tmurarka/Automated-Greenbox/Controls.png

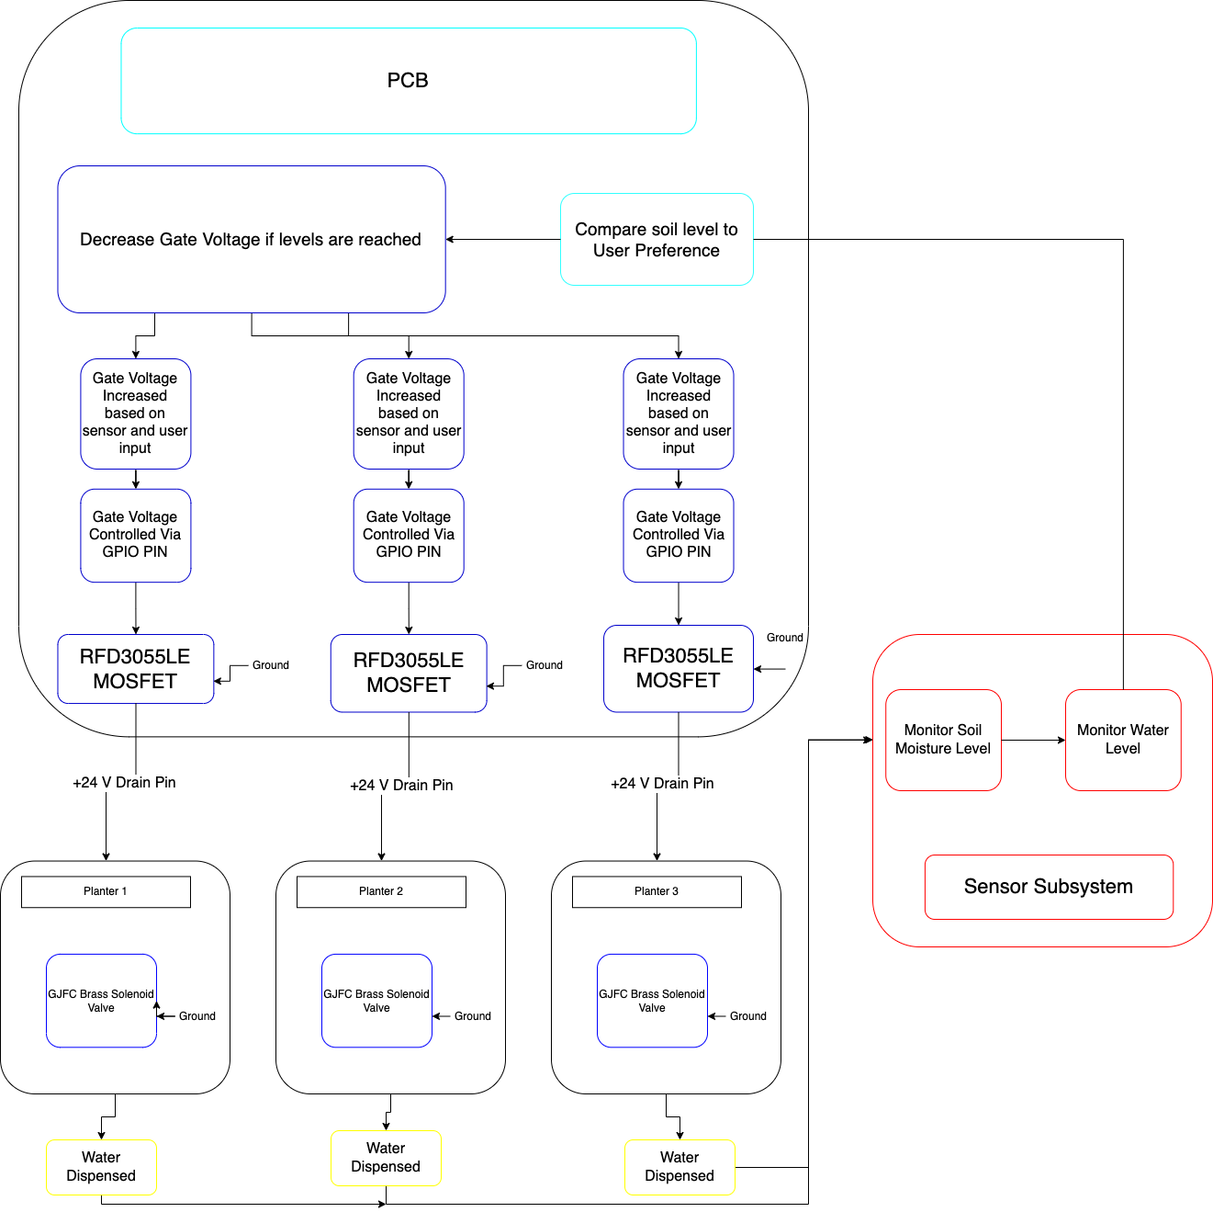
Controls.png
