tmurarka/Automated-Greenbox/PCB - Controls/Documentation/Screen Shot 2022-02-23.png

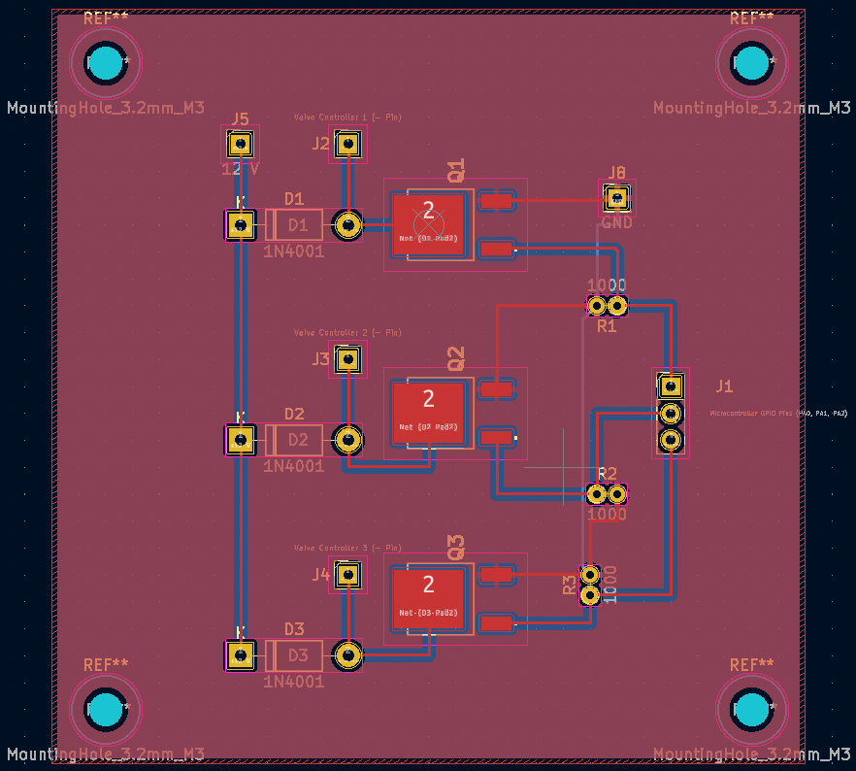
PCB - Controls/Documentation/Screen Shot 2022-02-23.png
