tmurarka/Automated-Greenbox/Picture1.png

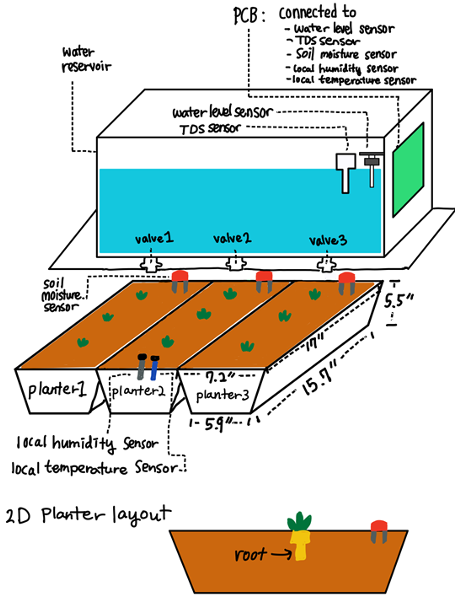
Picture1.png
