tmurarka/Automated-Greenbox/PCB - Controls/Documentation/Schematic.pdf

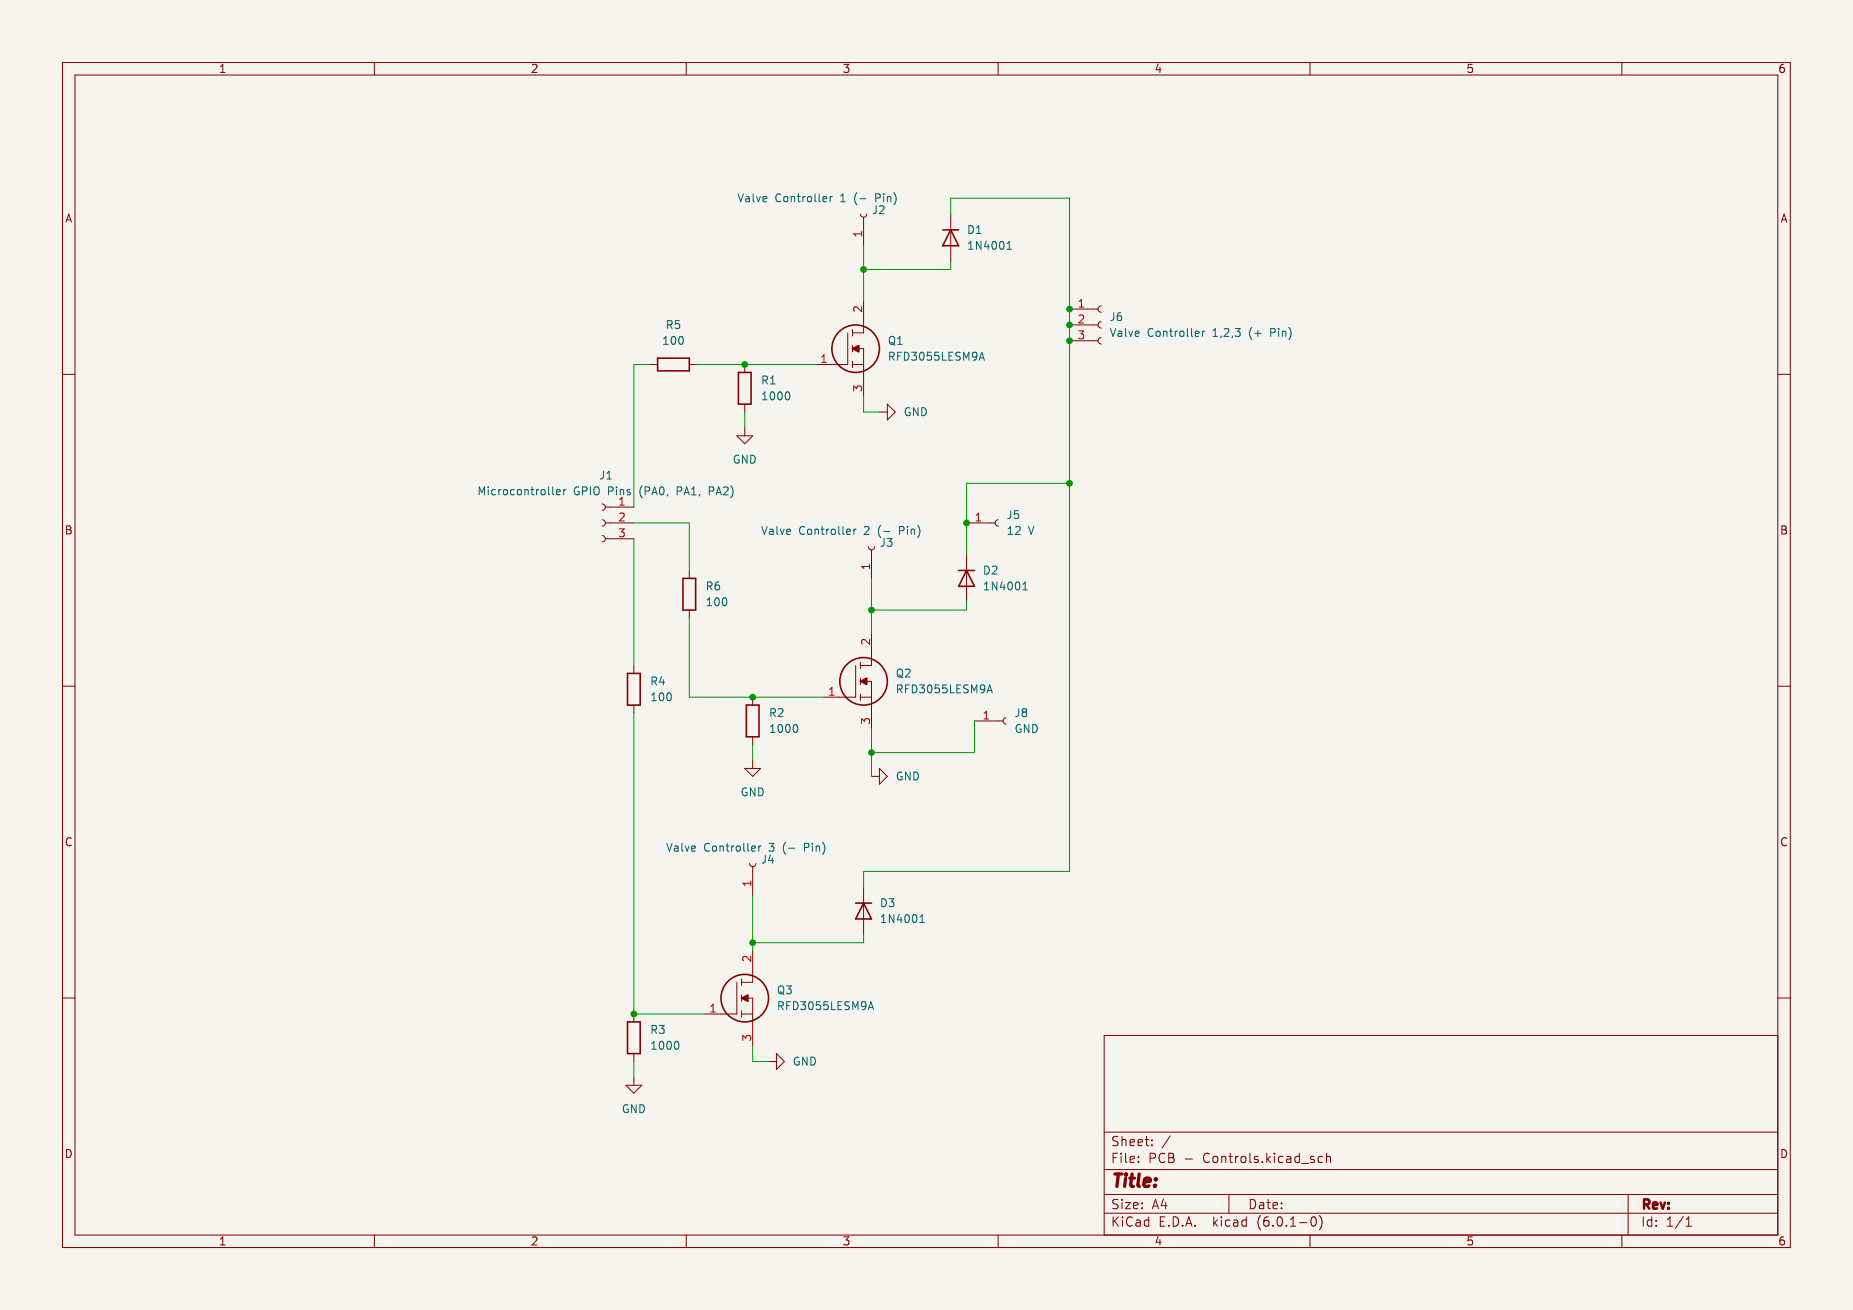
[picture p6: page 1]
