tmurarka/Automated-Greenbox/PCB - Controls/Documentation/Board.pdf

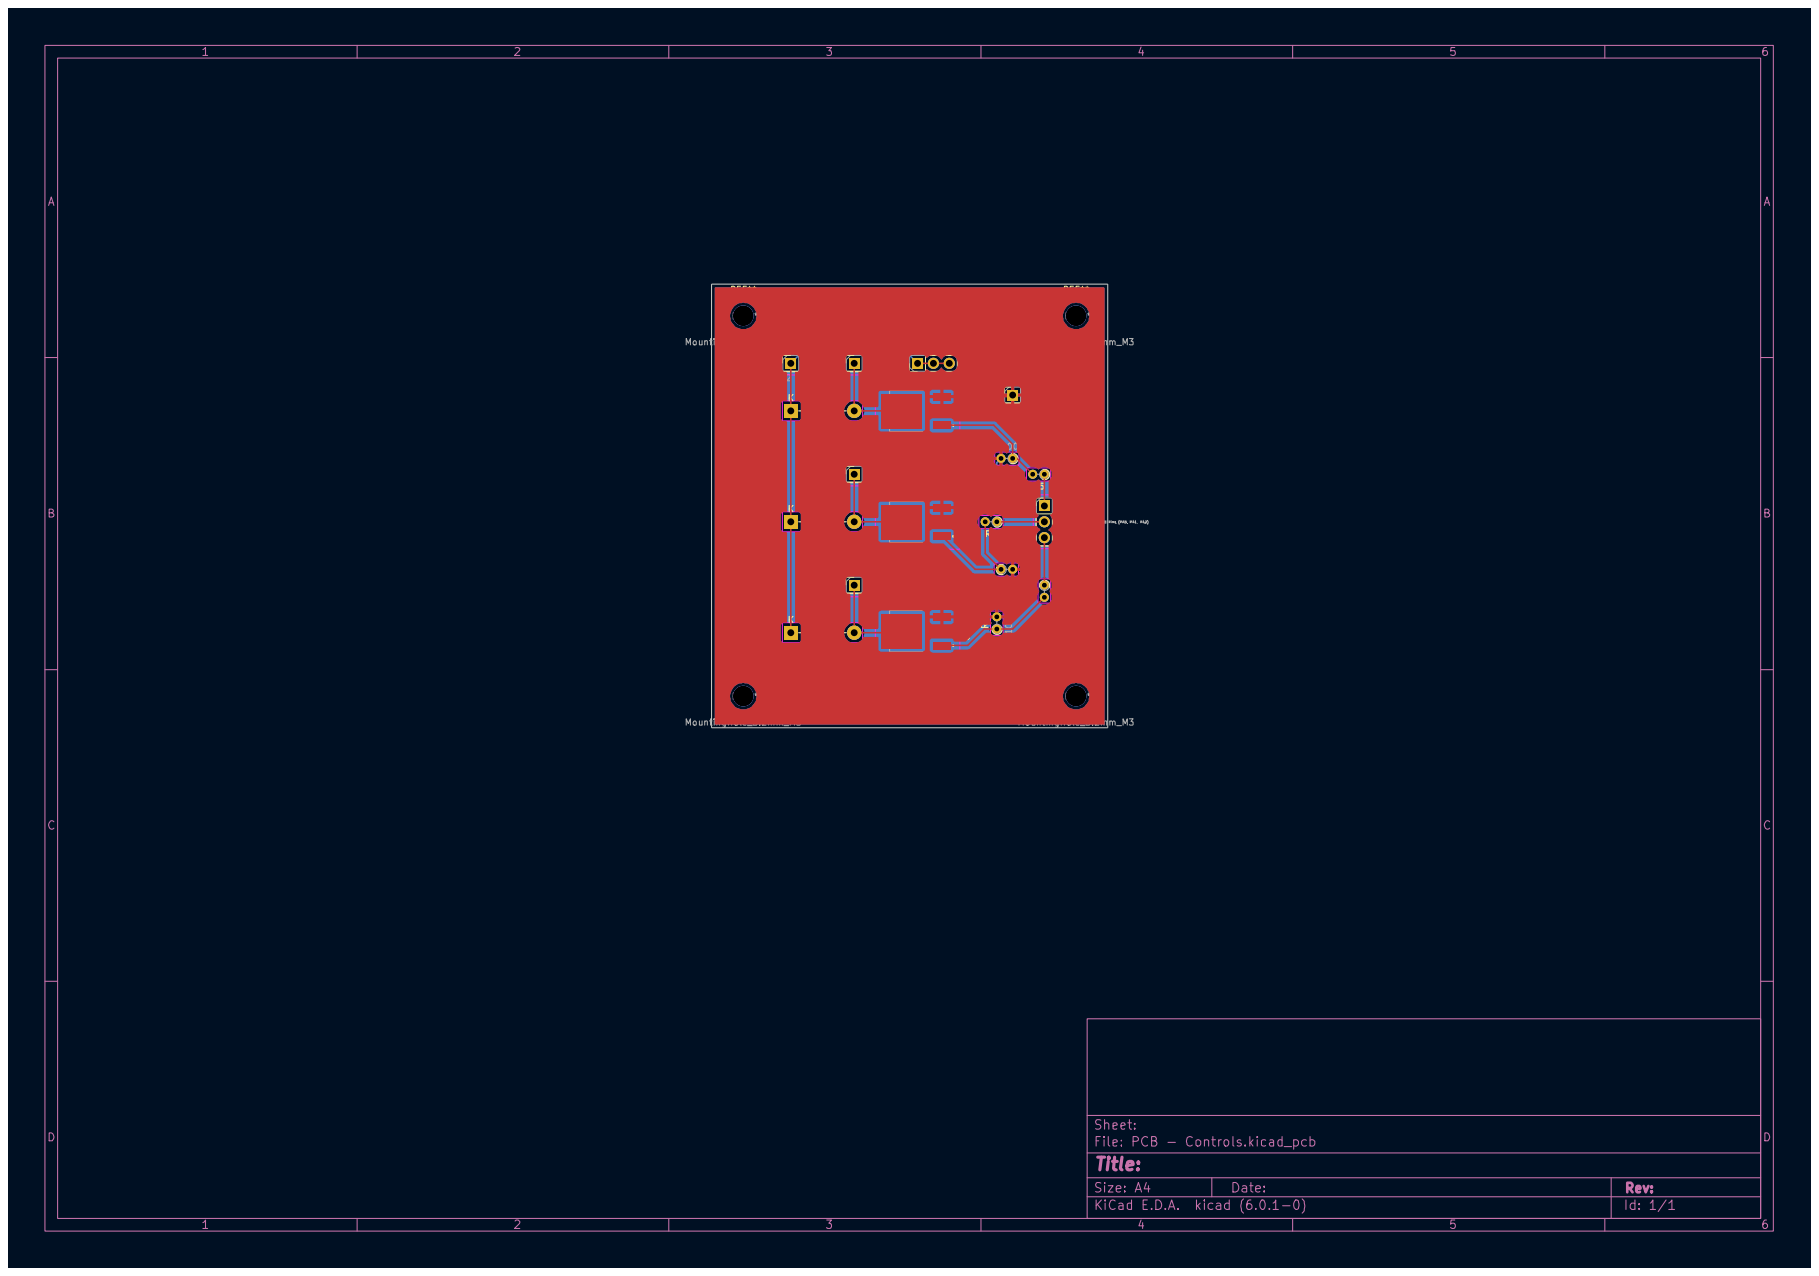
[picture p7: page 1]
