tmurarka/Automated-Greenbox/PCB - Controls/Documentation/PCB_Review.pdf

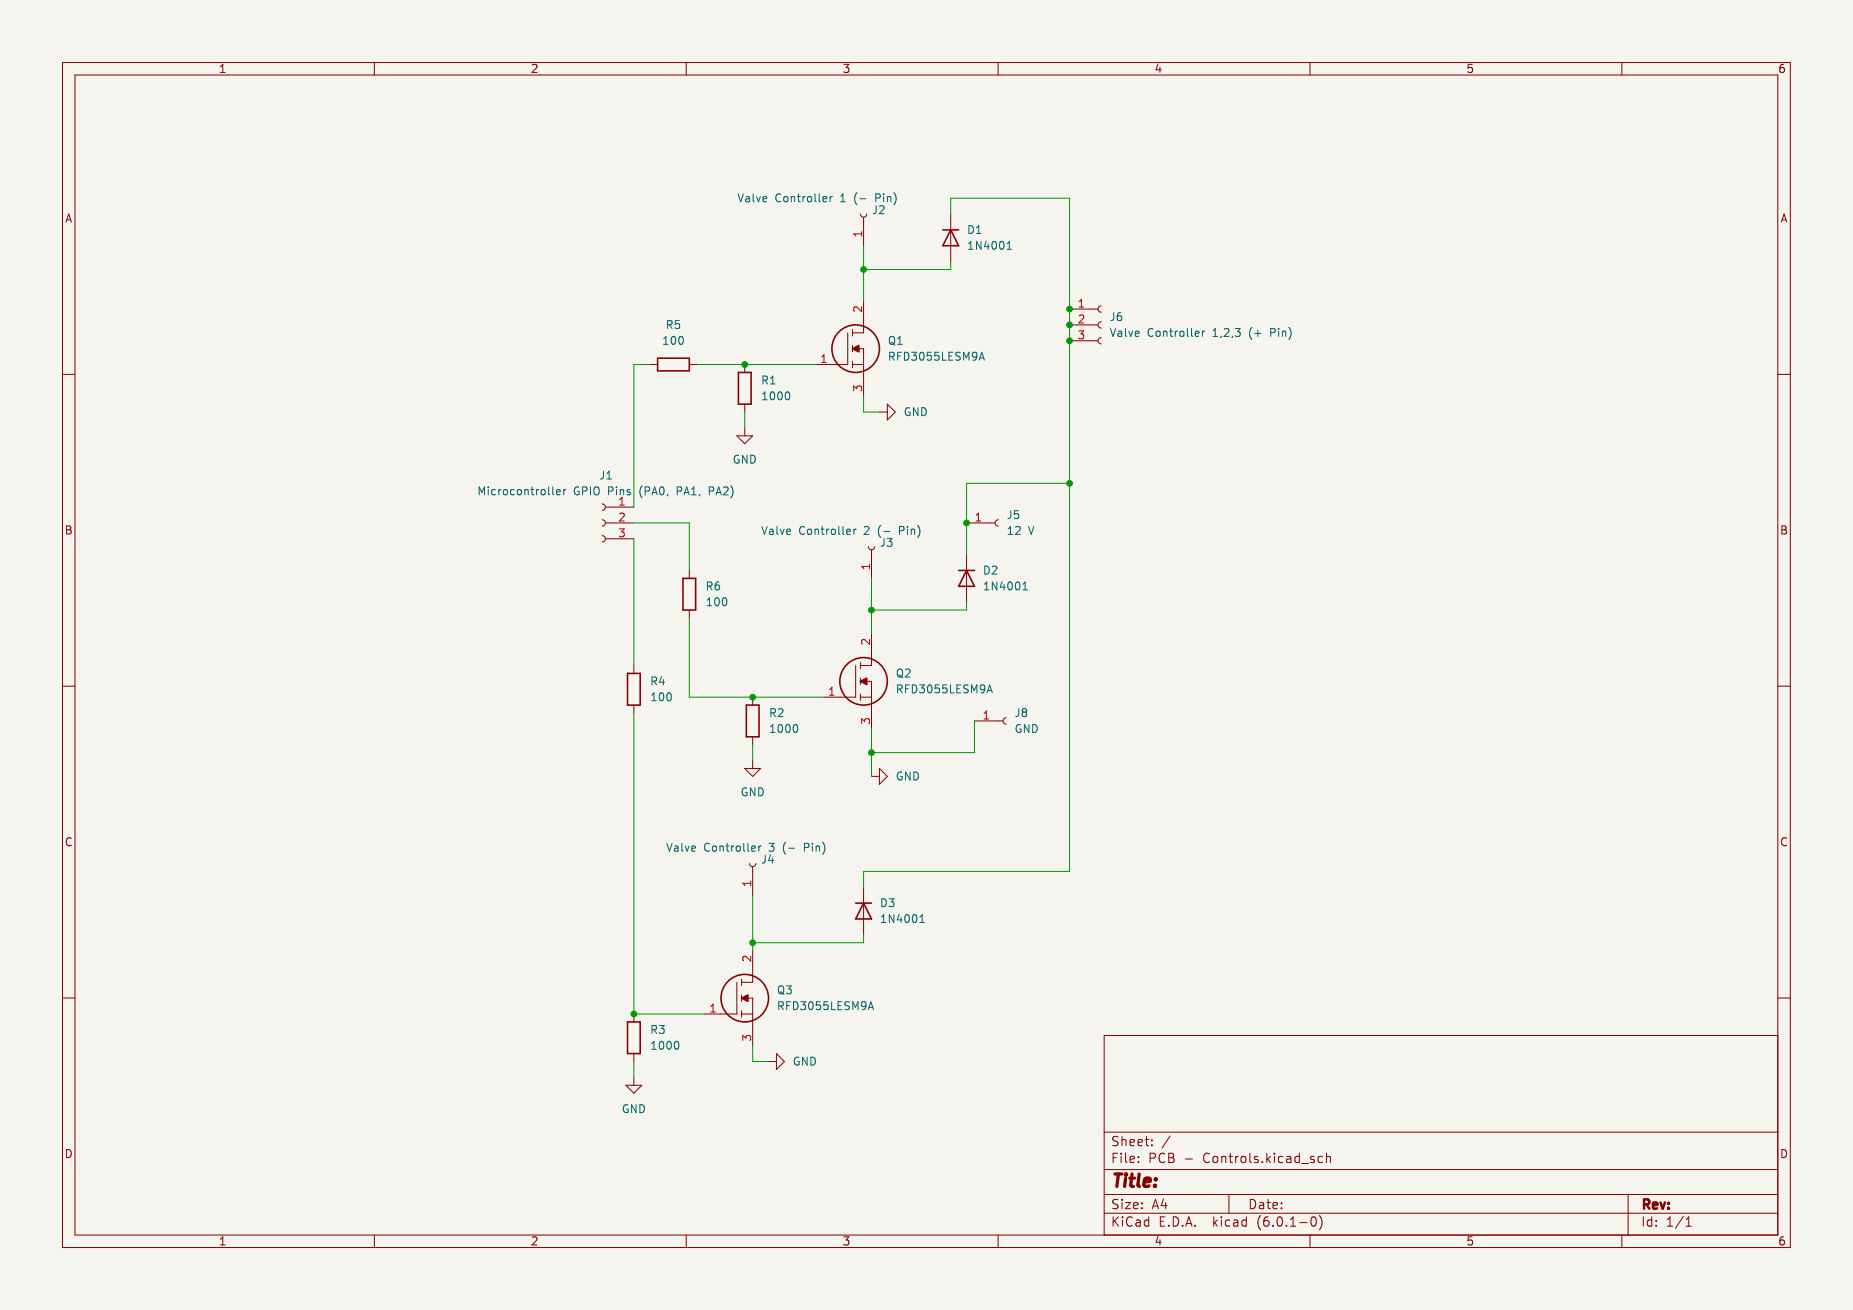
[picture p8: page 1]

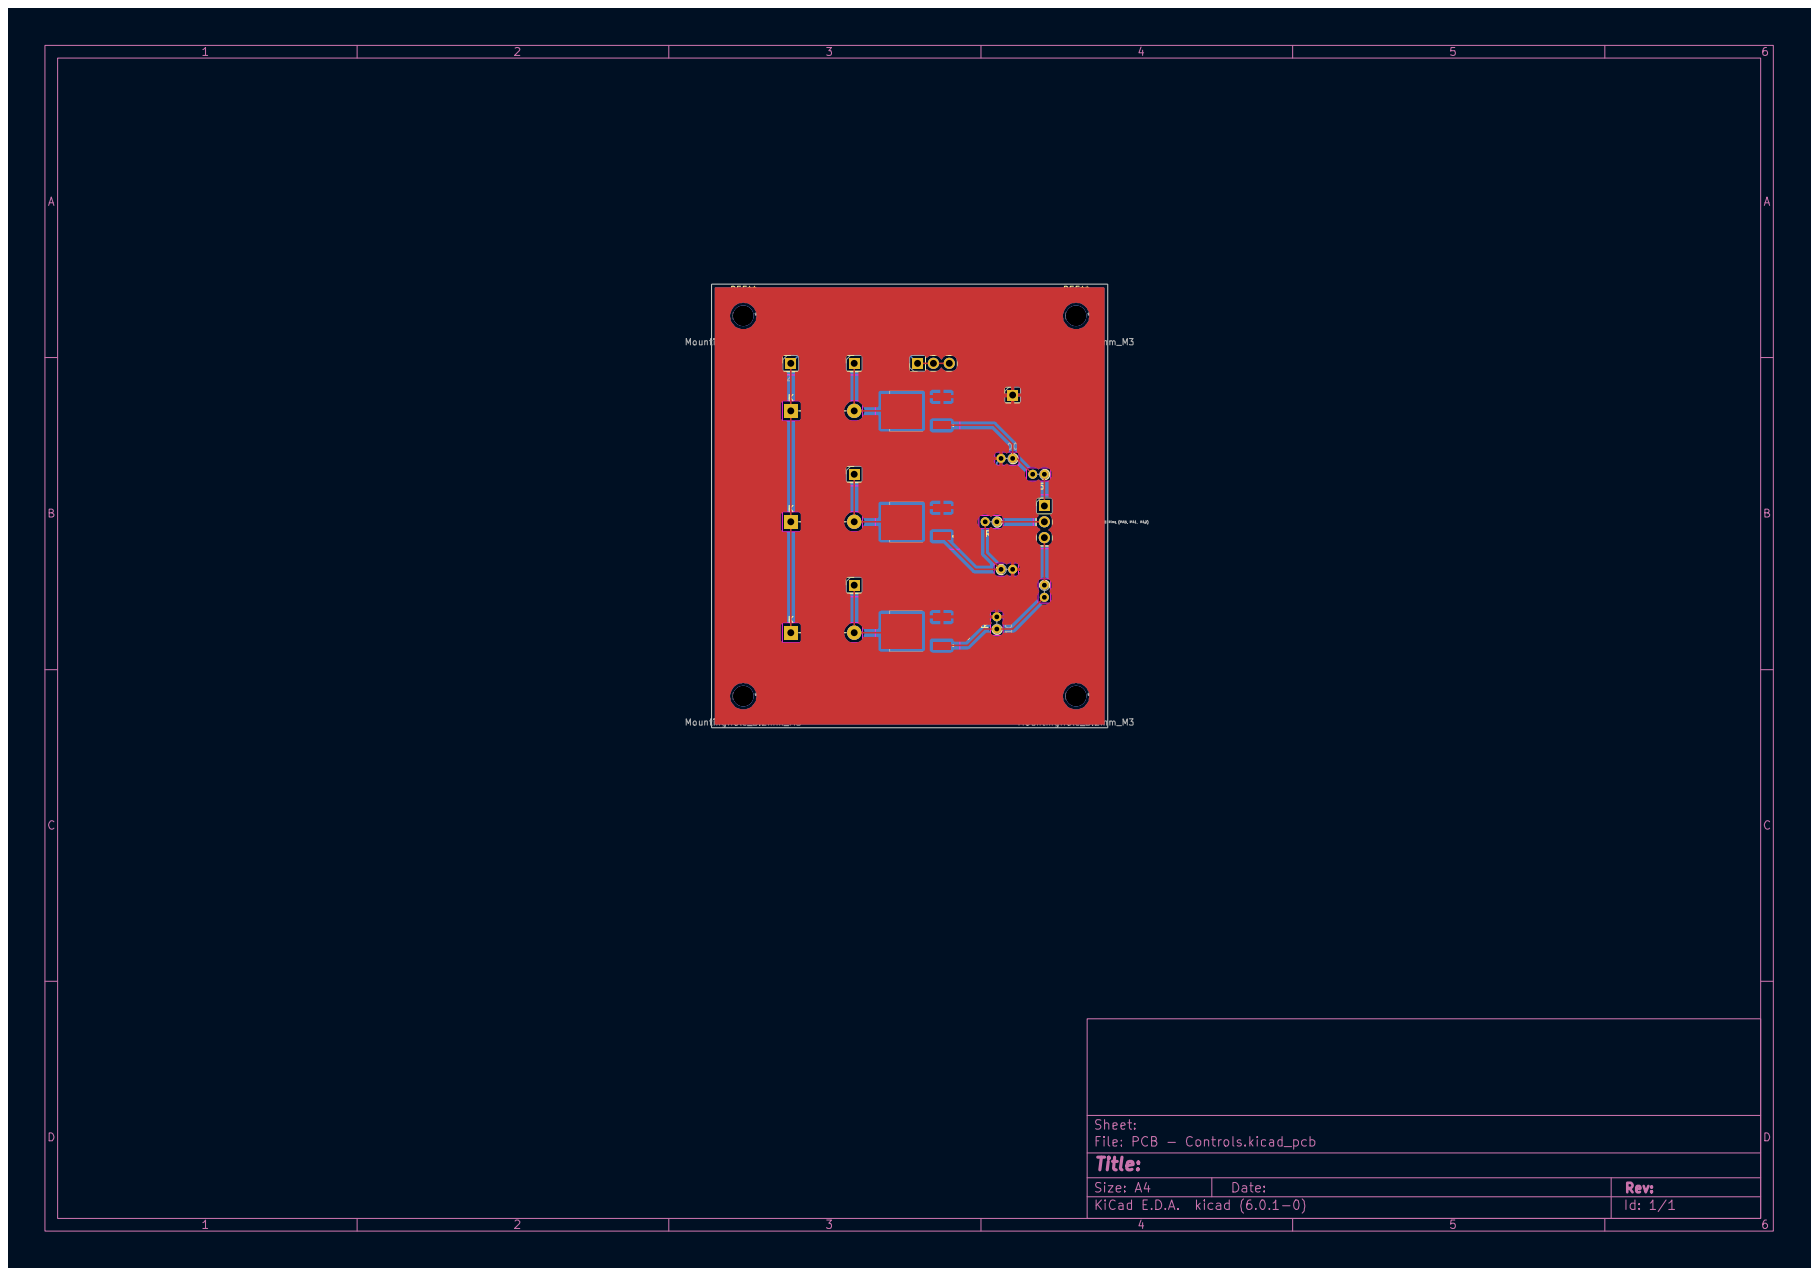
[picture p9: page 2]

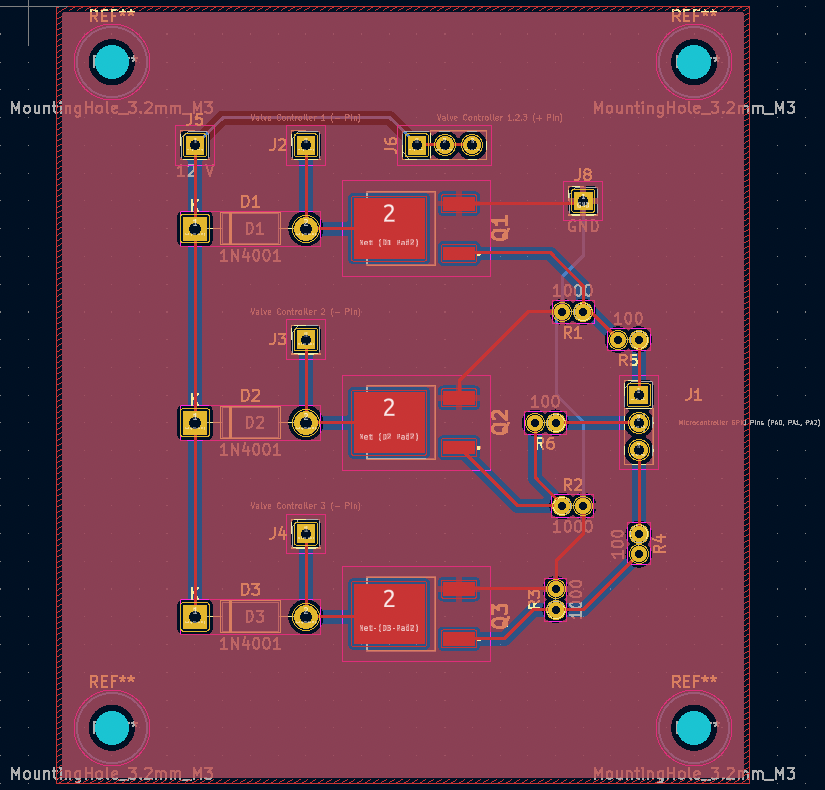
[picture p10: page 3]
