tmurarka/Automated-Greenbox/PCB - Controls/PCB - Controls.kicad_pcb

## KiCad design PCB - Controls/PCB - Controls.kicad_pcb (2022-11-08)

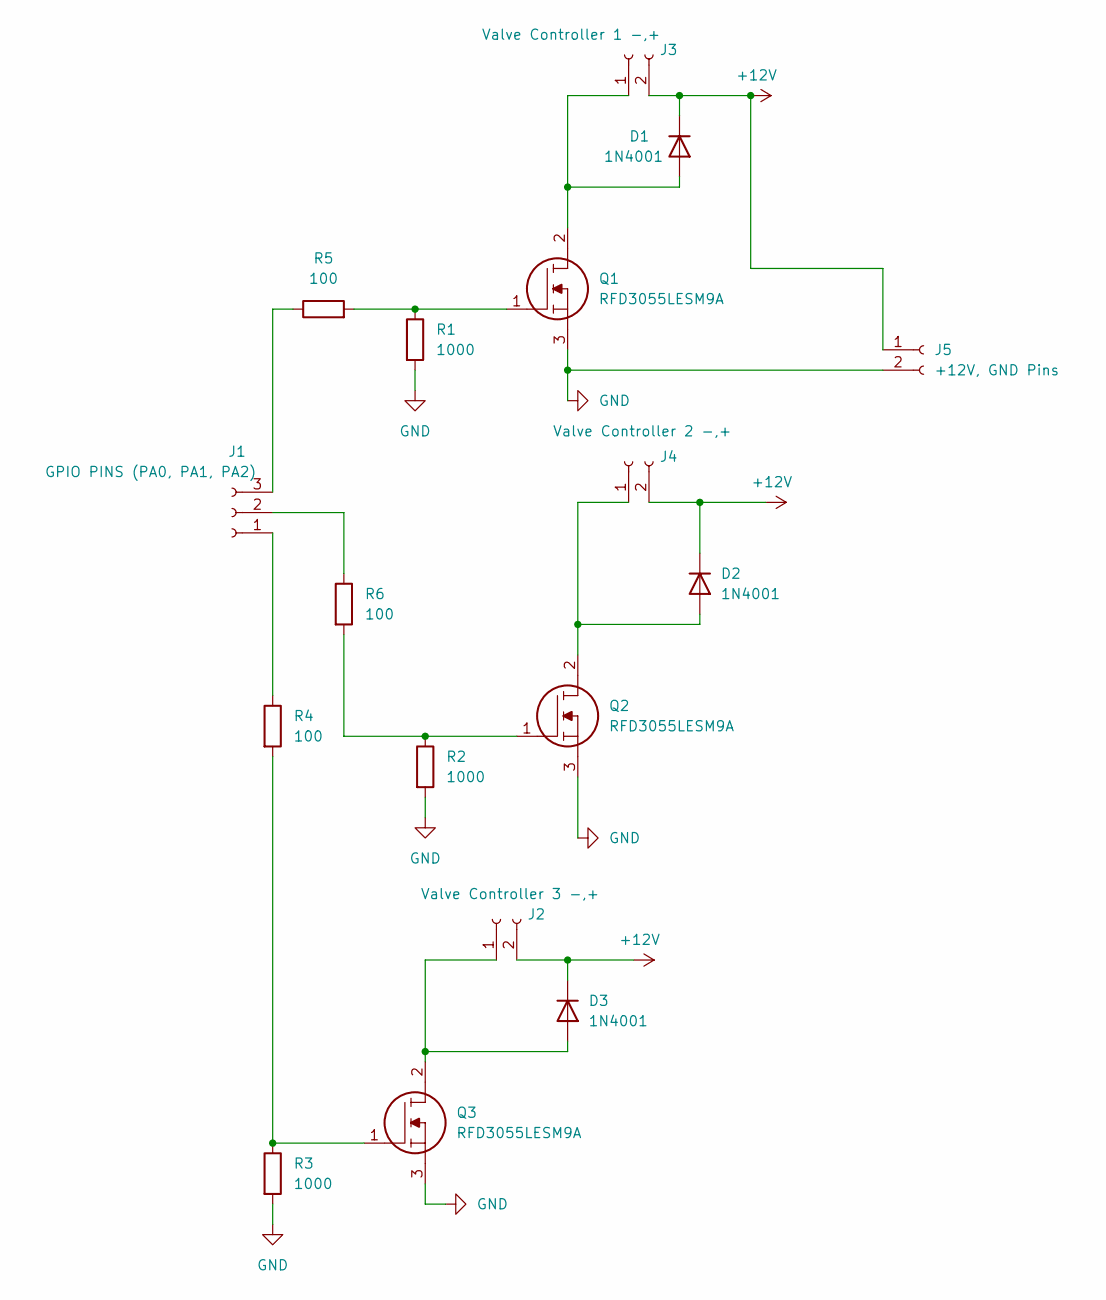
[picture p11: schematic PCB - Controls.kicad_sch]

Parts:
D1, D2, D3: 1N4001; D_DO-41_SOD81_P10.16mm_Horizontal
J1: GPIO PINS (PA0, PA1, PA2); PhoenixContact_MCV_1,5_3-G-3.81_1x03_P3.81mm_Vertical
J2: Valve Controller 3 -,+; PhoenixContact_MCV_1,5_2-G-3.81_1x02_P3.81mm_Vertical
J3: Valve Controller 1 -,+; PhoenixContact_MCV_1,5_2-G-3.81_1x02_P3.81mm_Vertical
J4: Valve Controller 2 -,+; PhoenixContact_MCV_1,5_2-G-3.81_1x02_P3.81mm_Vertical
J5: +12V, GND Pins; PhoenixContact_MCV_1,5_2-G-3.81_1x02_P3.81mm_Vertical
Q1, Q2, Q3: RFD3055LESM9A; FQD1N80TM; Mouser Part Number 512-RFD3055LESM9A
R1, R2, R3: 1000; R_Axial_DIN0204_L3.6mm_D1.6mm_P1.90mm_Vertical
R4, R5, R6: 100; R_Axial_DIN0204_L3.6mm_D1.6mm_P1.90mm_Vertical

Connections:
+12V: D1.1 (K), D2.1 (K), D3.1 (K), J2.2, J3.2, J4.2, J5.1
GND: J5.2, Q1.3, Q2.3, Q3.3, R1.2, R2.2, R3.2
unnamed: D1.2 (A), J3.1, Q1.2
unnamed: D2.2 (A), J4.1, Q2.2
unnamed: D3.2 (A), J2.1, Q3.2
unnamed: J1.1, R4.1
unnamed: J1.2, R6.1
unnamed: J1.3, R5.1
unnamed: Q1.1, R1.1, R5.2
unnamed: Q2.1, R2.1, R6.2
unnamed: Q3.1, R3.1, R4.2

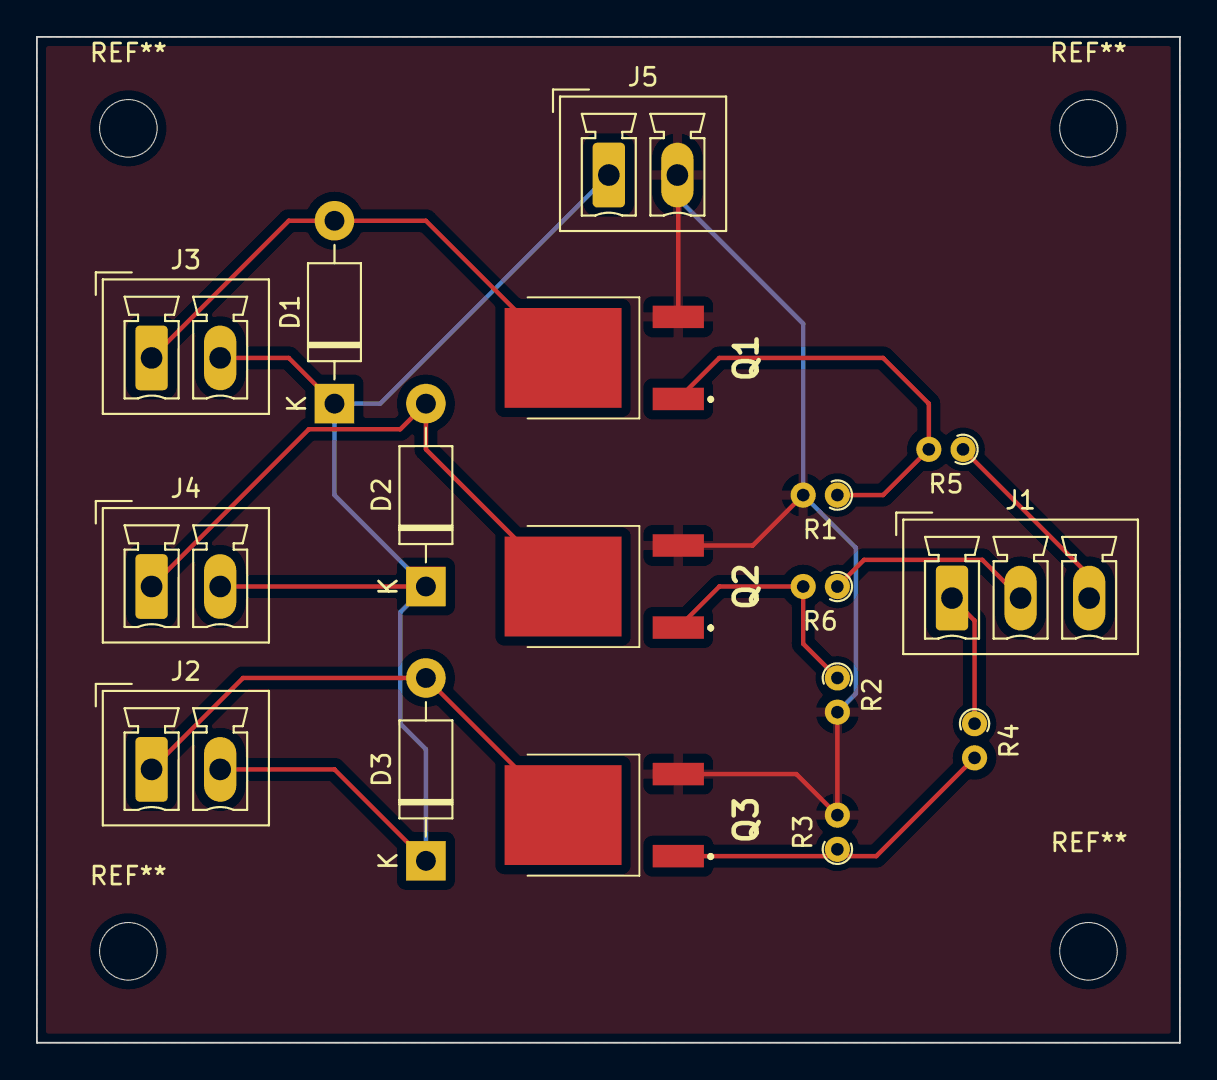
[picture p12: board PCB - Controls.kicad_pcb from above]

Board: 2 copper layers, 63.5 x 55.9 mm, 17 parts (0 on the bottom side), 11 nets.
